new-production-institute/Injection-Molding-Using-Resin-Based-3D-Printing/README.md

# Low-Cost Injection Molding at the Open Lab

This repository documents an ongoing project exploring low-cost injection molding at the Open Lab. The key idea: using MSLA and FDM 3D printing to create custom molds — an affordable and accessible approach for makers, educators, and FabLabs.

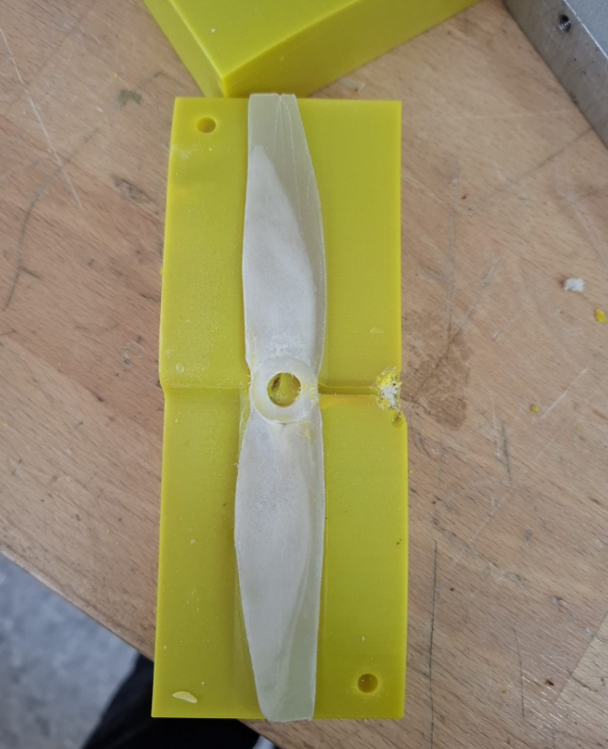
[picture p1: Pictures/finish_prop_mold_v3.png]
MSLA printed phonecase mold


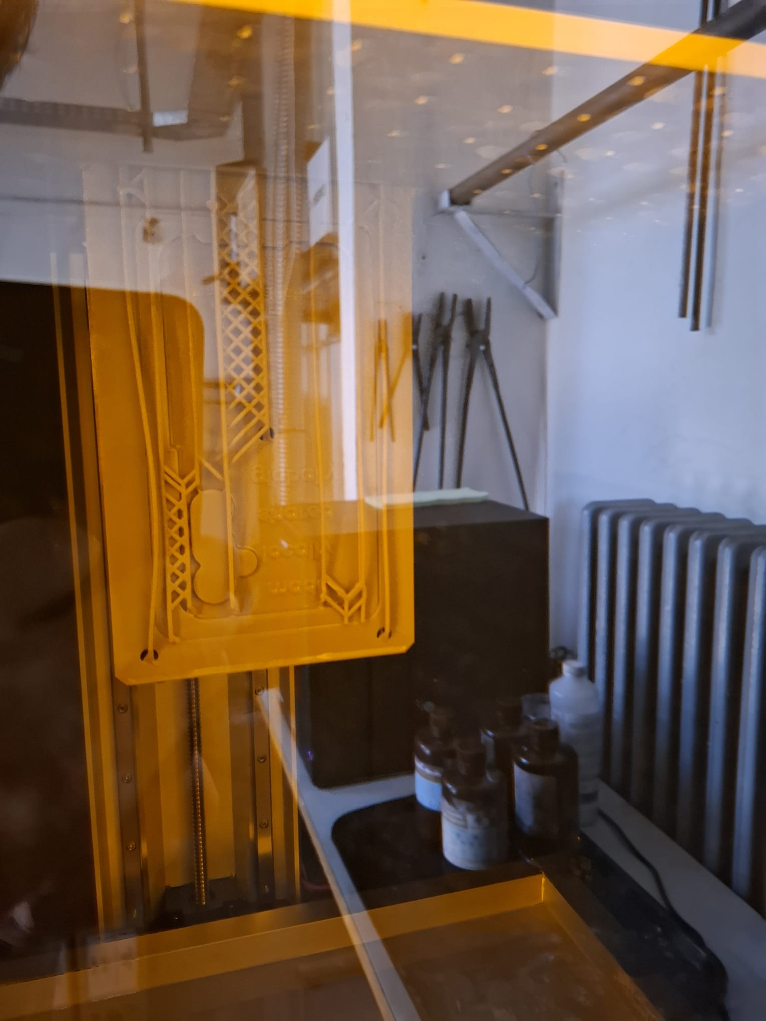
[picture p2: Pictures/printed_phone_case.jpg.jpg]
MSLA printed phonecase mold

---
