new-production-institute/Injection-Molding-Using-Resin-Based-3D-Printing/Pictures/image.png

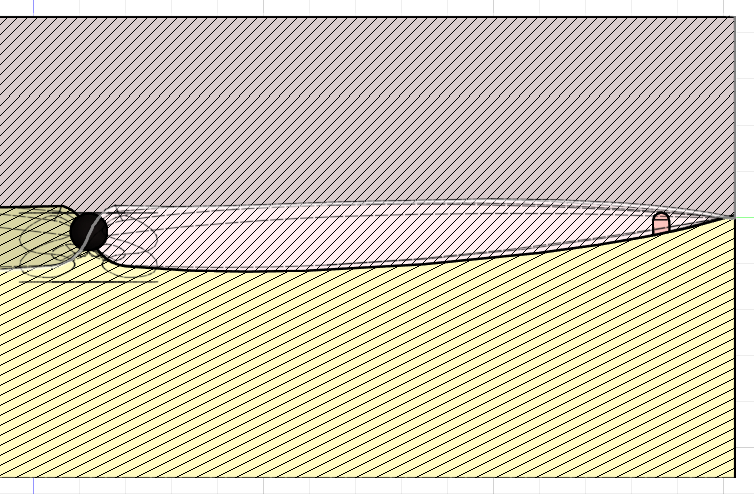
Pictures/image.png
