new-production-institute/Injection-Molding-Using-Resin-Based-3D-Printing/Pictures/Injection_hole.png

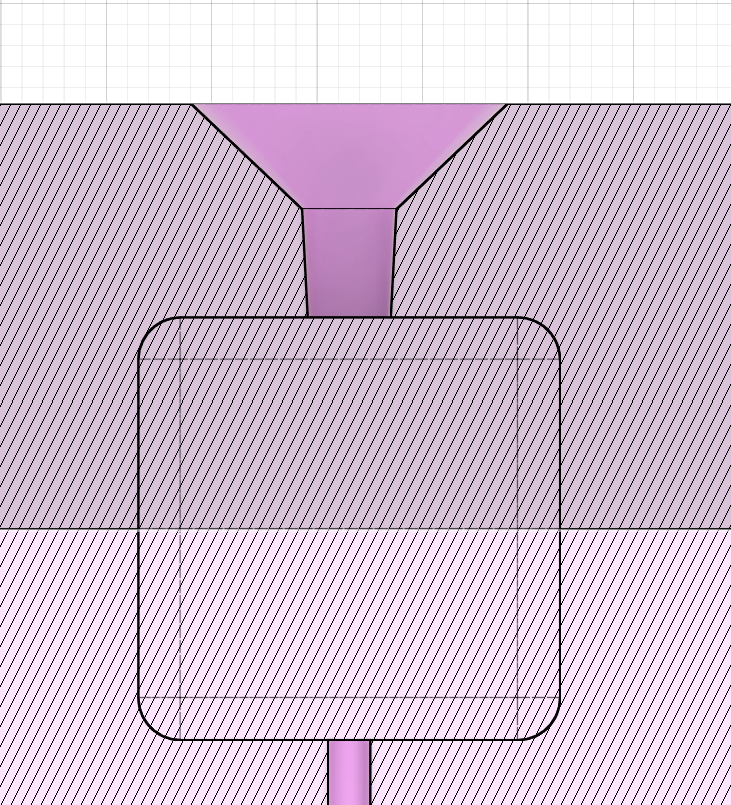
Pictures/Injection_hole.png
