new-production-institute/Injection-Molding-Using-Resin-Based-3D-Printing/Pictures/querschnitt.png

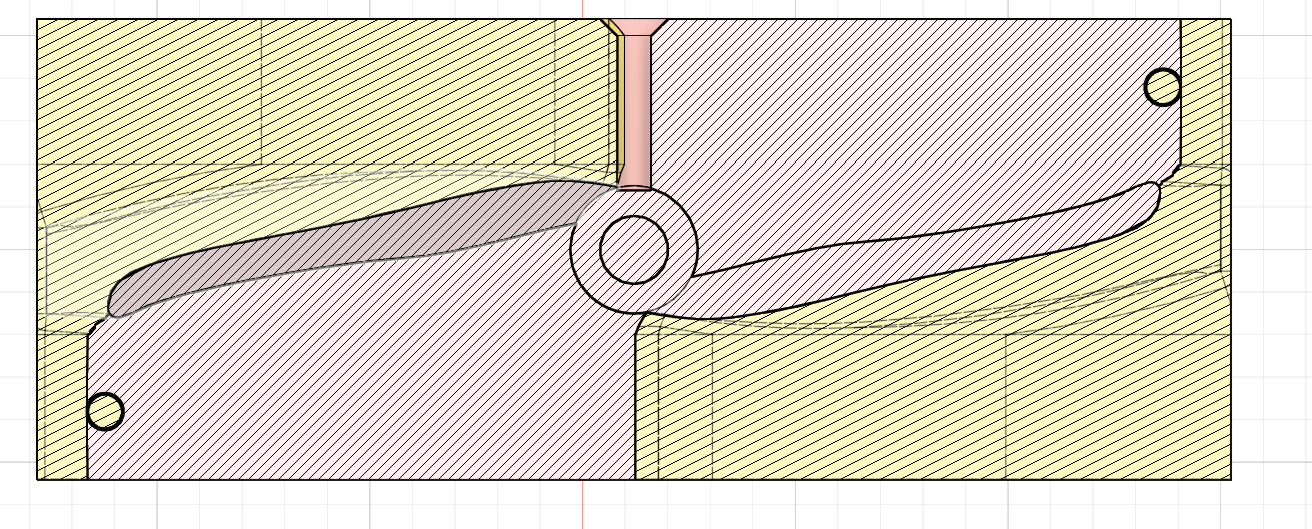
Pictures/querschnitt.png
