new-production-institute/Injection-Molding-Using-Resin-Based-3D-Printing/Mold Examples/Prop Mold/mold step.step

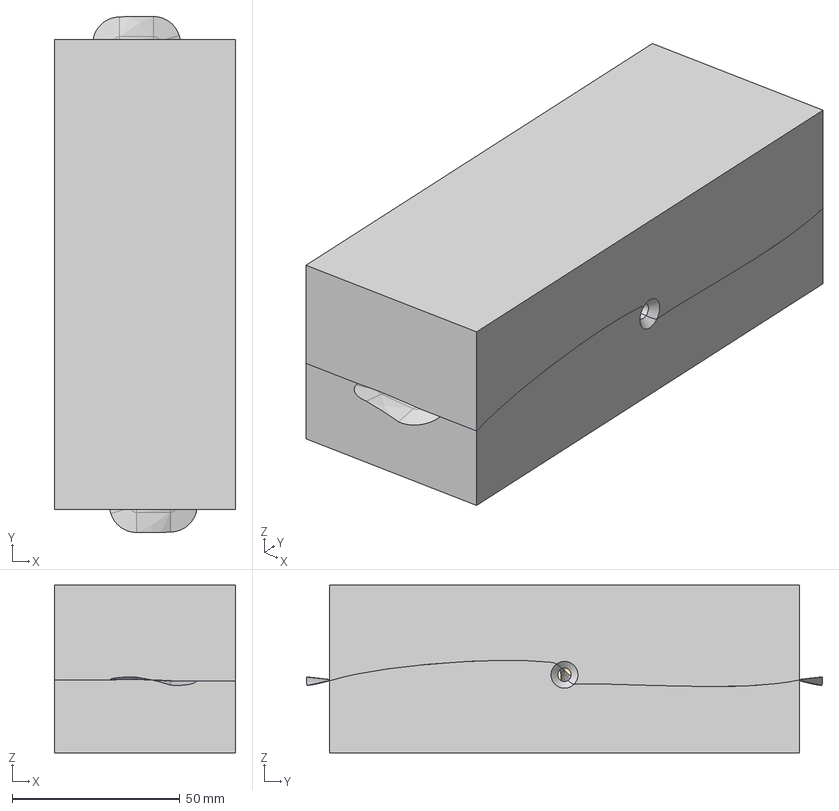
[picture p6: CAD file, 2025-08-18]
Mold Examples/Prop Mold/mold step.step
54.0 x 154.0 x 50.0 mm
