new-production-institute/Injection-Molding-Using-Resin-Based-3D-Printing/Mold Examples/Test cube mold + mold frame for milling/Bottom.stl

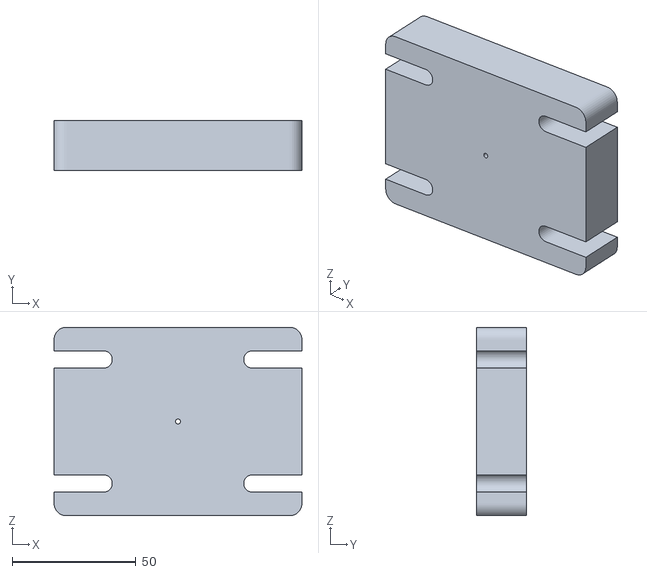
[picture p8: CAD file, 2025-08-18]
Mold Examples/Test cube mold + mold frame for milling/Bottom.stl
100.0 x 20.1 x 76.0
