new-production-institute/Injection-Molding-Using-Resin-Based-3D-Printing/Mold Examples/Prop Mold/Bottom.stl

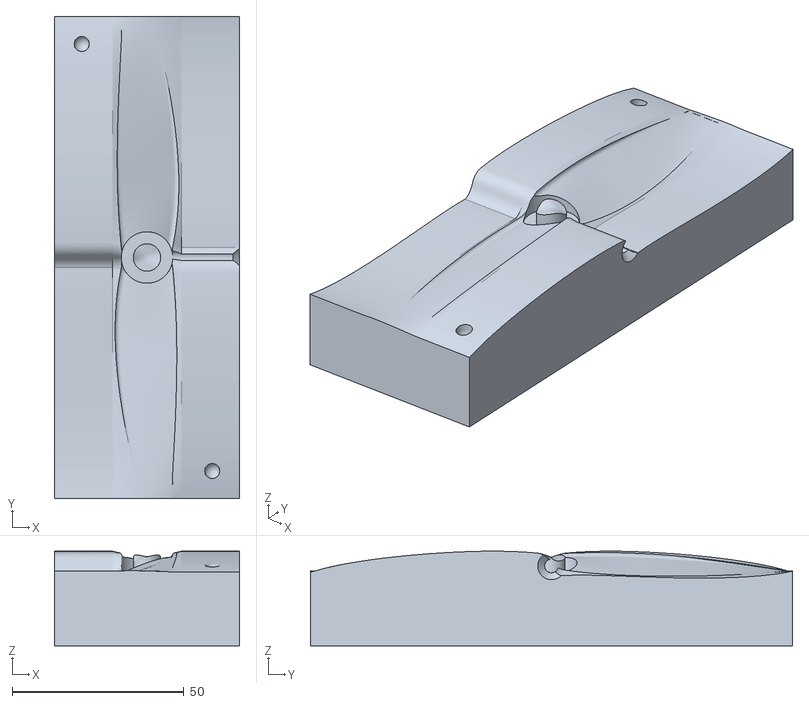
[picture p9: CAD file, 2025-08-18]
Mold Examples/Prop Mold/Bottom.stl
54.0 x 140.4 x 27.6
