new-production-institute/Injection-Molding-Using-Resin-Based-3D-Printing/Mold Examples/Samsung A55 phone case mold/Top.stl

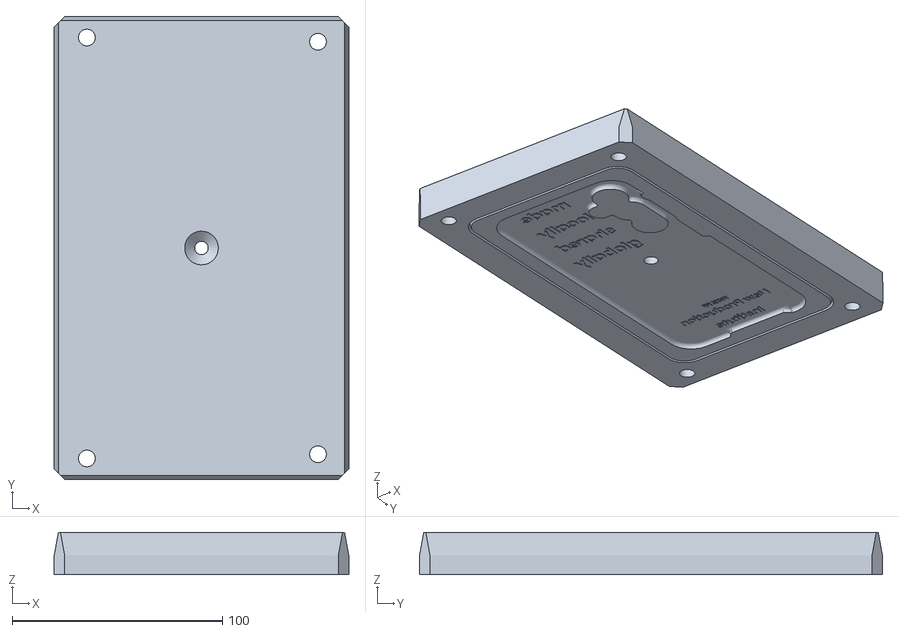
[picture p10: CAD file, 2025-08-18]
Mold Examples/Samsung A55 phone case mold/Top.stl
140.0 x 220.0 x 20.0
