new-production-institute/Injection-Molding-Using-Resin-Based-3D-Printing/Mold Examples/Test cube mold + mold frame for milling/Mold step.step

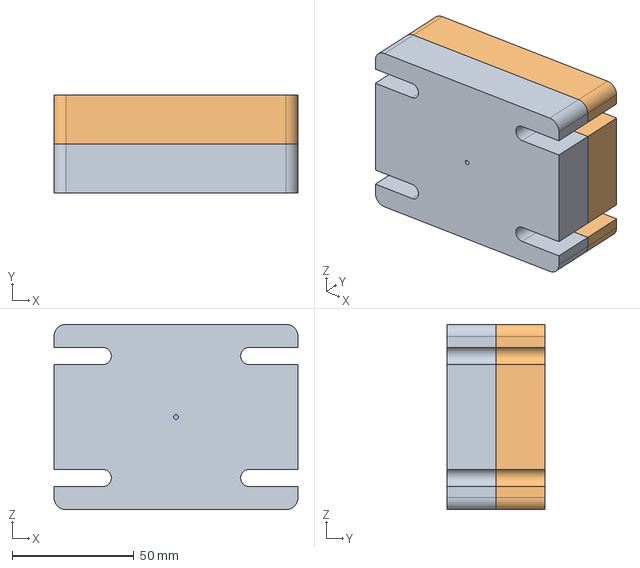
[picture p11: CAD file, 2025-08-18]
Mold Examples/Test cube mold + mold frame for milling/Mold step.step
100.0 x 40.2 x 76.0 mm
