new-production-institute/Injection-Molding-Using-Resin-Based-3D-Printing/Mold Examples/Prop Mold/Top.stl

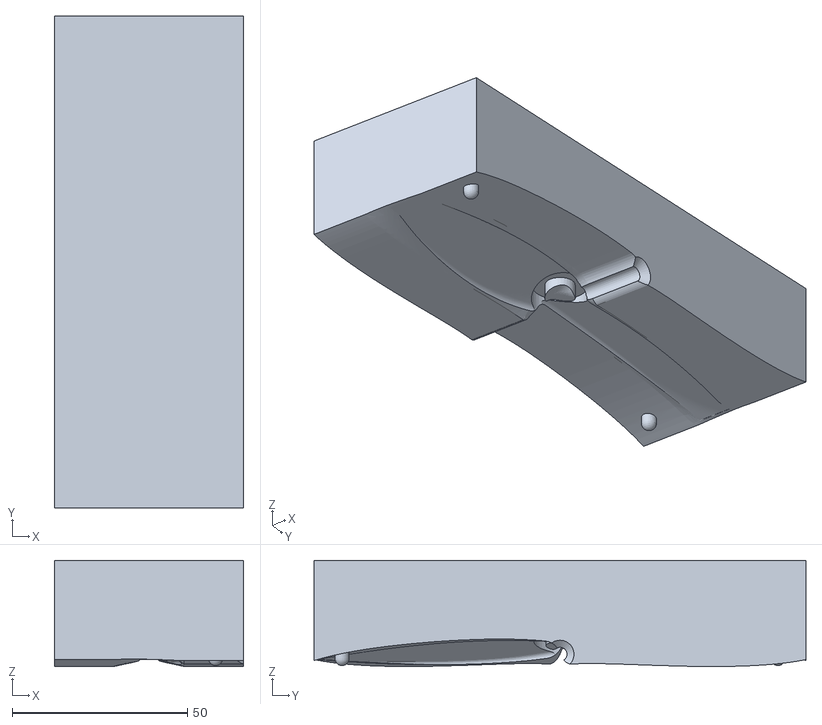
[picture p12: CAD file, 2025-08-18]
Mold Examples/Prop Mold/Top.stl
54.0 x 140.4 x 30.3
