new-production-institute/Injection-Molding-Using-Resin-Based-3D-Printing/Mold Examples/Samsung A55 phone case mold/Insert.stl

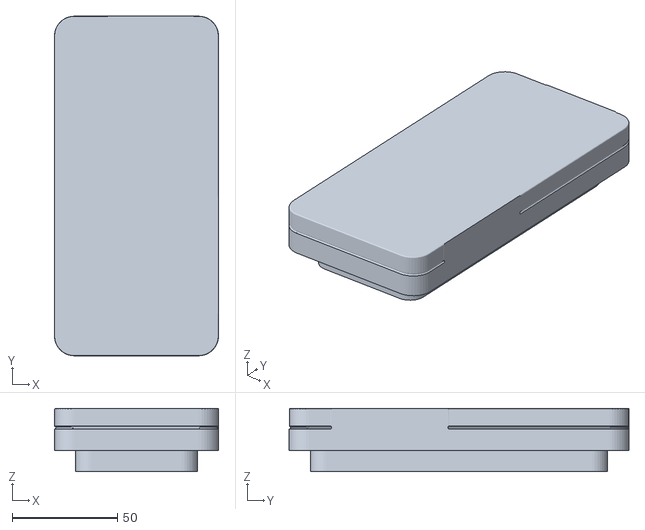
[picture p13: CAD file, 2025-08-18]
Mold Examples/Samsung A55 phone case mold/Insert.stl
77.8 x 161.1 x 30.0
