new-production-institute/Injection-Molding-Using-Resin-Based-3D-Printing/Mold Examples/Test cube mold + mold frame for milling/Cube.stl

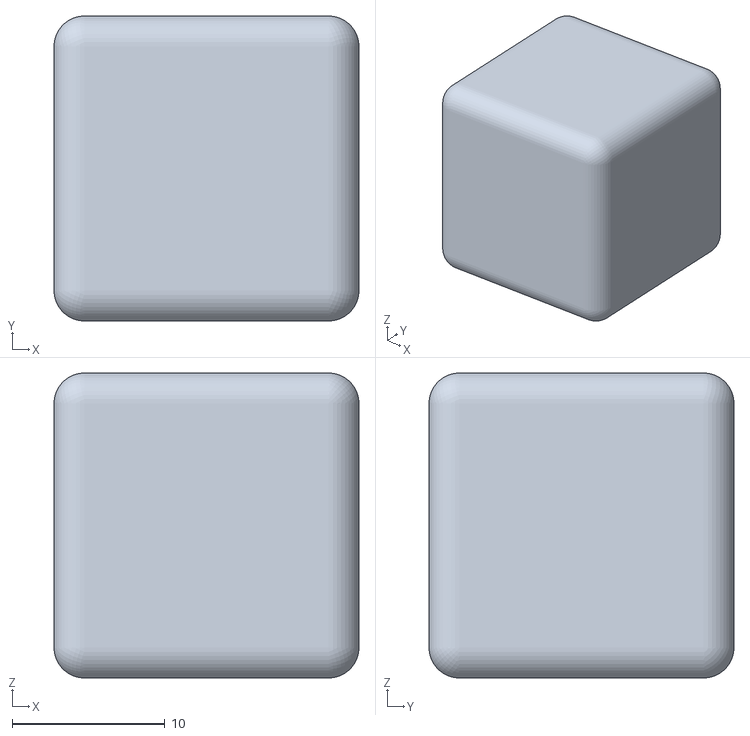
[picture p14: CAD file, 2025-08-18]
Mold Examples/Test cube mold + mold frame for milling/Cube.stl
20.0 x 20.0 x 20.0
