new-production-institute/Injection-Molding-Using-Resin-Based-3D-Printing/Mold Examples/Prop Mold/Prop.stl

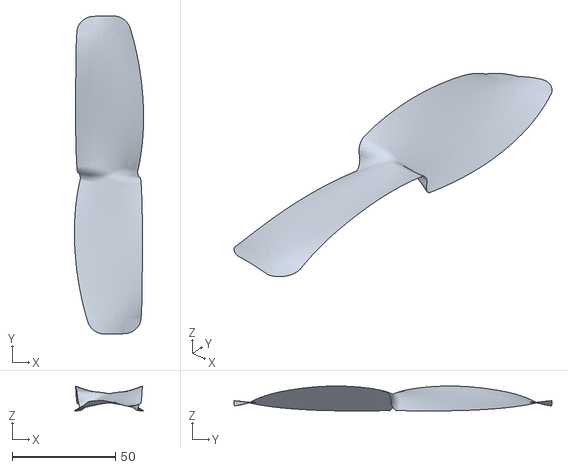
[picture p15: CAD file, 2025-08-18]
Mold Examples/Prop Mold/Prop.stl
33.5 x 154.0 x 12.1
