new-production-institute/Injection-Molding-Using-Resin-Based-3D-Printing/Mold Examples/Samsung A55 phone case mold/Phone Case .stl

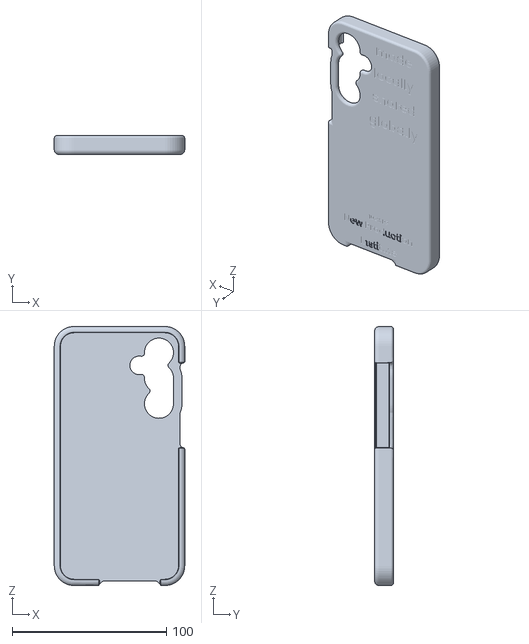
[picture p16: CAD file, 2025-08-18]
Mold Examples/Samsung A55 phone case mold/Phone Case .stl
84.6 x 12.3 x 167.9
