new-production-institute/Injection-Molding-Using-Resin-Based-3D-Printing/Mold Examples/Samsung A55 phone case mold/mold step.step

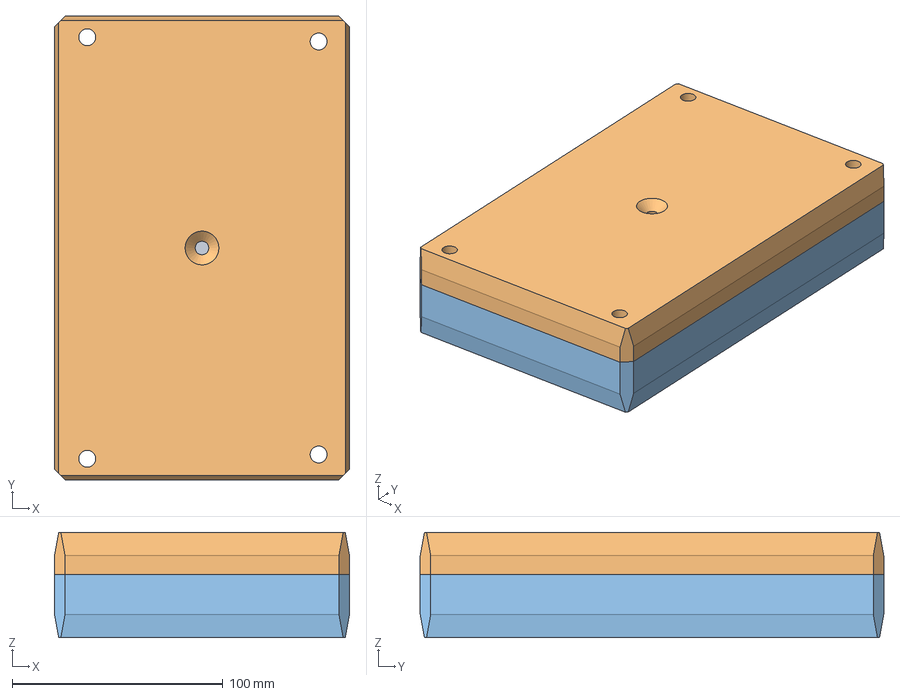
[picture p17: CAD file, 2025-08-18]
Mold Examples/Samsung A55 phone case mold/mold step.step
140.0 x 220.0 x 50.0 mm
