new-production-institute/Injection-Molding-Using-Resin-Based-3D-Printing/(list of files, cad)

Other CAD files:
Mold Examples/Test cube mold + mold frame for milling/Top.stl
Mold Examples/Prop Mold/Prop mold v4.f3d
Mold Examples/Test cube mold + mold frame for milling/Mould Frame v4.f3d
