new-production-institute/Injection-Molding-Using-Resin-Based-3D-Printing/(commit log)

2025-08-18 Create Manufacturing Injection Molds with an MSLA 3D-Printer.md4
2025-08-21 new Basic Principles of Designing Injection Molds for Resin Printing
2025-09-18 Added Plate leveling infos
